alvarop/blemesh/hw/blemesh.kicad_pcb

## KiCad design hw/blemesh.kicad_pcb (2018-05-28)

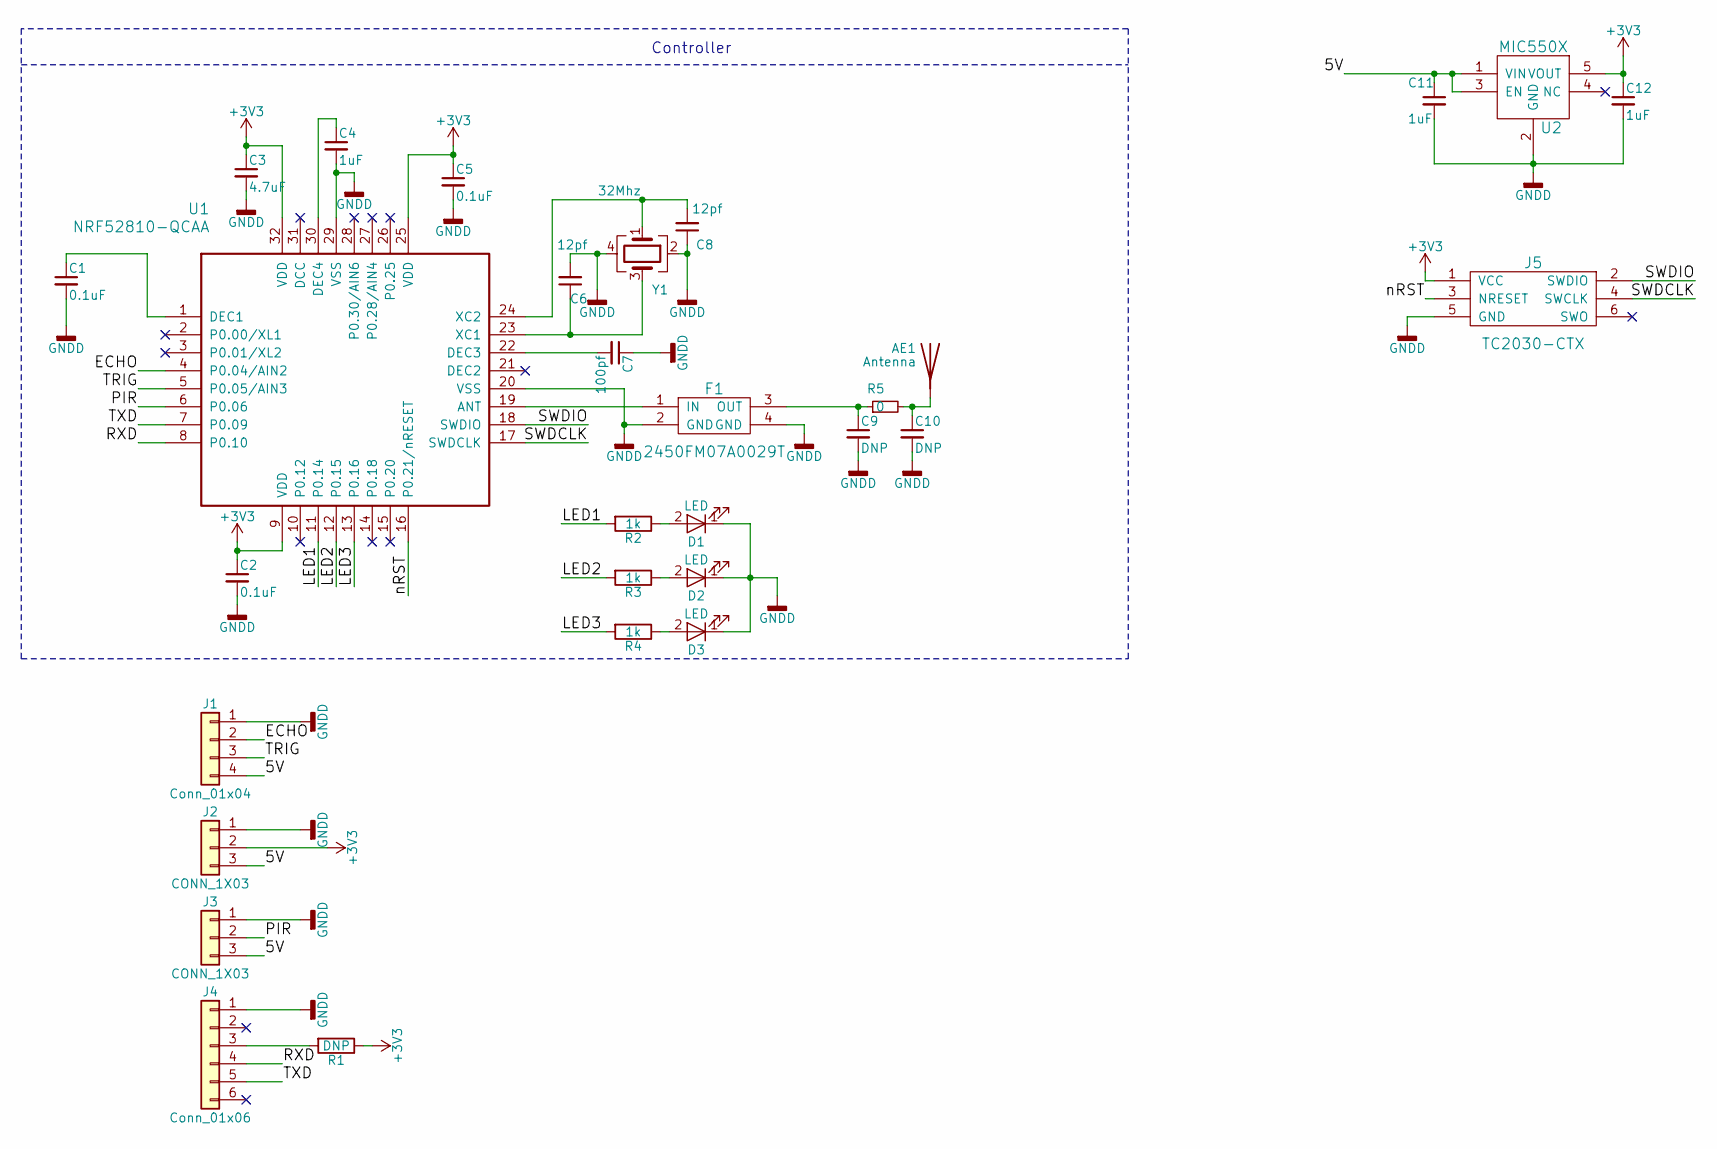
[picture p1: schematic blemesh.sch, Nui]

Parts:
AE1: Antenna; AMCA31-2R450G-S1F-T3
C1, C2, C5: 0.1uF; C_0402
C3: 4.7uF; C_0603
C4: 1uF; C_0402
C6, C8: 12pf; C_0402
C7: 100pf; C_0402
C9, C10: DNP; C_0402
C11, C12: 1uF; C_0603
D1, D2, D3: LED; LED_0402
F1: 2450FM07A0029T
J1: Conn_01x04; Pin_Header_Straight_1x04_Pitch2.54mm
J2, J3: CONN_1X03; Pin_Header_Straight_1x03_Pitch2.54mm
J4: Conn_01x06; Pin_Header_Straight_1x06_Pitch2.54mm
J5: TC2030-CTX; TC2030-NL
R1: DNP; R_0402
R2, R3, R4: 1k; R_0402
R5: 0; R_0402_NoSilk
U1: NRF52810-QCAA; NRF52810_QCAA_QFN32
U2: MIC550X; SOT-23(M5)
Y1: 32Mhz; Crystal_SMD_2016-4pin_2.0x1.6mm

Connections:
+3V3: C2.1, C3.1, C5.1, C12.1, J2.2, J5.1 (VCC), R1.1, U1.9 (VDD), U1.25 (VDD), U1.32 (VDD), U2.5 (VOUT)
/5V: C11.1, J1.4, J2.3, J3.3, U2.1 (VIN), U2.3 (EN)
/ECHO: J1.2, U1.4 (P0.04/AIN2)
/LED1: R2.2, U1.11 (P0.14)
/LED2: R3.2, U1.12 (P0.15)
/LED3: R4.2, U1.13 (P0.16)
/PIR: J3.2, U1.6 (P0.06)
/RXD: J4.4, U1.8 (P0.10)
/SWDCLK: J5.4 (SWCLK), U1.17 (SWDCLK)
/SWDIO: J5.2 (SWDIO), U1.18 (SWDIO)
/TRIG: J1.3, U1.5 (P0.05/AIN3)
/TXD: J4.5, U1.7 (P0.09)
/nRST: J5.3 (NRESET), U1.16 (P0.21/nRESET)
GNDD: C1.2, C2.2, C3.2, C4.2, C5.2, C6.2, C7.1, C8.1, C9.2, C10.2, C11.2, C12.2, D1.1 (K), D2.1 (K), D3.1 (K), F1.2 (GND), F1.4 (GND), J1.1, J2.1, J3.1, J4.1, J5.5 (GND), U1.20 (VSS), U1.29 (VSS), U2.2 (GND), Y1.2, Y1.4
unnamed: AE1.1, C10.1, R5.2
unnamed: C1.1, U1.1 (DEC1)
unnamed: C4.1, U1.30 (DEC4)
unnamed: C6.1, U1.23 (XC1), Y1.3
unnamed: C7.2, U1.22 (DEC3)
unnamed: C8.2, U1.24 (XC2), Y1.1
unnamed: C9.1, F1.3 (OUT), R5.1
unnamed: D1.2 (A), R2.1
unnamed: D2.2 (A), R3.1
unnamed: D3.2 (A), R4.1
unnamed: F1.1 (IN), U1.19 (ANT)
unnamed: J4.3, R1.2

Notes on the sheet:
Controller

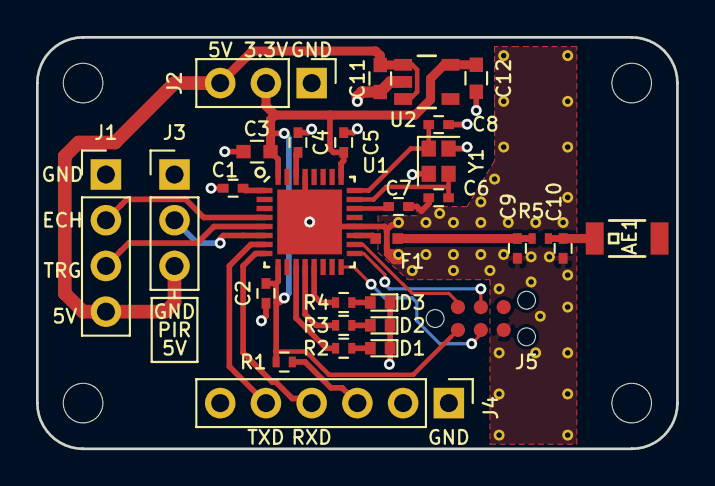
[picture p2: board blemesh.kicad_pcb from above]

Board: 2 copper layers, 35.6 x 22.9 mm, 30 parts (0 on the bottom side), 26 nets.
