alvarop/blemesh/(commit log)

2018-05-17 First commit. HW v0.1 and blinky fw
    [blemesh.kicad_pcb, blemesh.sch]
2018-05-19 Trying out ws2812 LEDs
2018-05-20 Playing with the ultrasonic sensor
2018-05-28 Adding SPI-WS2812 LUT script
2018-05-28 Removed paste layer from tag connect footprint
    [blemesh.kicad_pcb]
